kariagepompadour/KariPom/docs/karipom_ear/Karipom Ear Pico2H 書き込み手順（完成版）.docx

2026/07/18

# Karipom Ear Pico2H 書き込み手順（完成版）

対象スケッチ

pico2-pcm1808/karipom_pico2/karipom_pico2.ino（GitHub公開版。旧開発名：Karipom_Ear_Pico_Step2_UART_Echo）

※スケッチ内部のヘッダには開発当時の名称（Step2）が残っていますが、中身は完成版です。

# ① Pico2HをBOOTSELモードにする

1. Pico2Hの BOOTSELボタン を押したまま
2. USBケーブルをMacへ接続
3. BOOTSELボタンを離す

Finderに

RPI-RP2

というドライブが現れればOK。

# ② Arduino IDEを起動

開くスケッチ

pico2-pcm1808/karipom_pico2/karipom_pico2.ino（GitHub公開版。旧開発名：Karipom_Ear_Pico_Step2_UART_Echo）

# ③ ボード設定

ツール → ボード

Raspberry Pi Pico/RP2040

↓

Raspberry Pi Pico 2

# ④ ポート設定

ポートは

UF2 Board

または

RPI-RP2

を選択。

※通常の /dev/cu.usbmodem... はまだ表示されなくて正常。

# ⑤ 書き込み

Arduino IDE の

→（書き込み）

を押す。

数秒で

Done uploading.

になれば成功。

Pico2Hは自動で再起動する。

# ⑥ シリアルモニタ

再起動後、

ツール → ポート

から

/dev/cu.usbmodem******

を選択。

シリアル速度

115200

# ⑦ 動作確認（無音時）

正常なら

ST> rmsDb=-98.0 gate=closed fft/s=25 mi=0 ovf=0 lb=--

TX> FFT:0,0,0,0,0,0,0,0

のような表示が出る。

確認ポイント

- ✅ gate=closed
- ✅ fft/s=25
- ✅ mi=0
- ✅ ovf=0

# ⑧ PCM1808接続後

音楽を流すと

gate=open

となり、

FFT値が変化すれば正常。

# ⑨ CoreS3接続後

CoreS3側で

EAR SPEAK_START

が表示され、

- グライコ
- 口パク

が動けば完成。

## 現在の完成版ファイル

### Pico2H

pico2-pcm1808/karipom_pico2/karipom_pico2.ino（GitHub公開版。旧開発名：Karipom_Ear_Pico_Step2_UART_Echo）

### CoreS3

karipom_20260716_EAR_STEP5_1.ino

💡 メモ

フォルダ名が「Step2」のため紛らわしいですが、Pico2H側はこのStep2が最終完成版です。CoreS3側だけが Step5.1 まで進化しています。
