kariagepompadour/KariPom/sdcard/faces/karipom_default.png

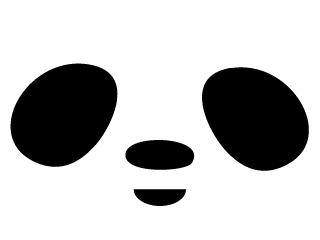
sdcard/faces/karipom_default.png
