kariagepompadour/KariPom/sdcard/faces/kawaii_01.png

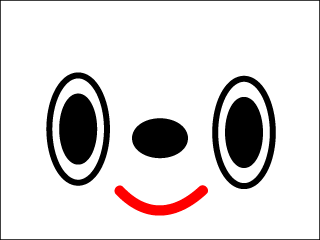
sdcard/faces/kawaii_01.png
