kariagepompadour/KariPom/sdcard/faces/kawaii_02.png

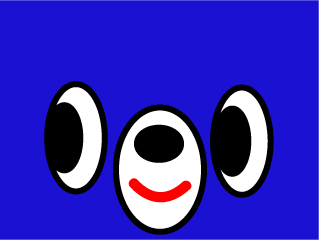
sdcard/faces/kawaii_02.png
