kariagepompadour/KariPom/sdcard/faces/kawaii_03.png

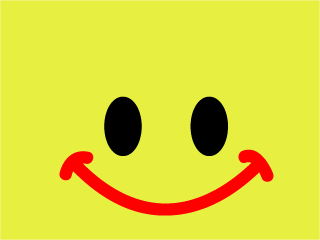
sdcard/faces/kawaii_03.png
