kariagepompadour/KariPom/sdcard/faces/kawaii_04.png

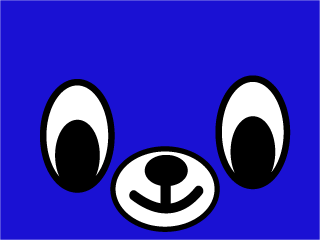
sdcard/faces/kawaii_04.png
