kariagepompadour/KariPom/sdcard/faces/kawaii_05.png

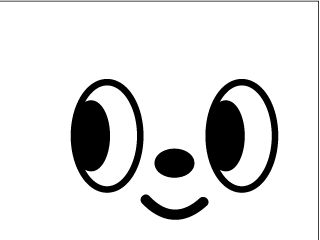
sdcard/faces/kawaii_05.png
