kariagepompadour/KariPom/sdcard/faces/kawaii_06.png

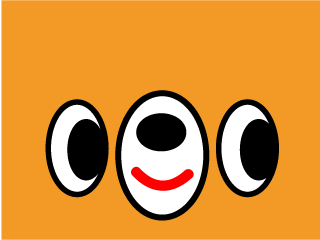
sdcard/faces/kawaii_06.png
