kariagepompadour/KariPom/sdcard/faces/nazousa_pink.png

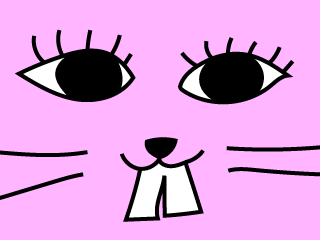
sdcard/faces/nazousa_pink.png
