kariagepompadour/KariPom/sdcard/faces/robo_white.png

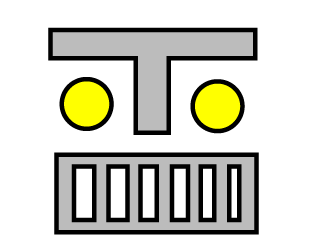
sdcard/faces/robo_white.png
