kariagepompadour/KariPom/sdcard/faces/smile_320x240.png

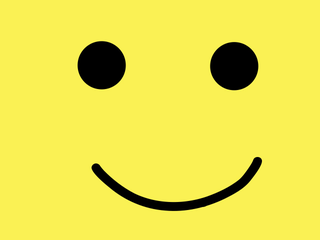
sdcard/faces/smile_320x240.png
