kariagepompadour/KariPom/3d_models/karipom.3mf

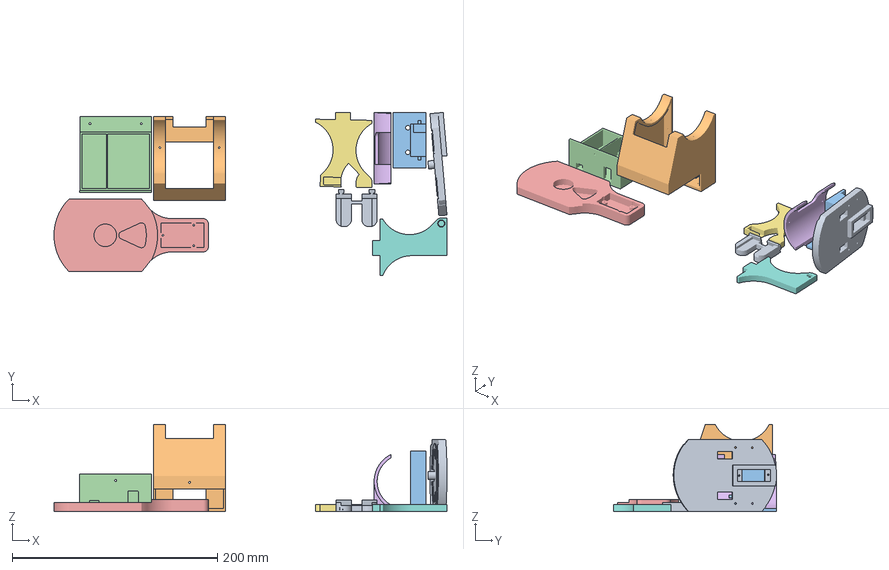
[picture p17: CAD file, 2026-08-01]
3d_models/karipom.3mf
383.1 x 159.1 x 85.2 mm
コンポーネント1.stl
コンポーネント12.stl
ボディ47.stl
ボディ1.stl
ボディ74.stl
コンポーネント9.stl
コンポーネント7.stl
コンポーネント2.stl
ボディ18_fixed.stl
