kariagepompadour/KariPom/3d_models/stl/karipom_hip_lineout.stl

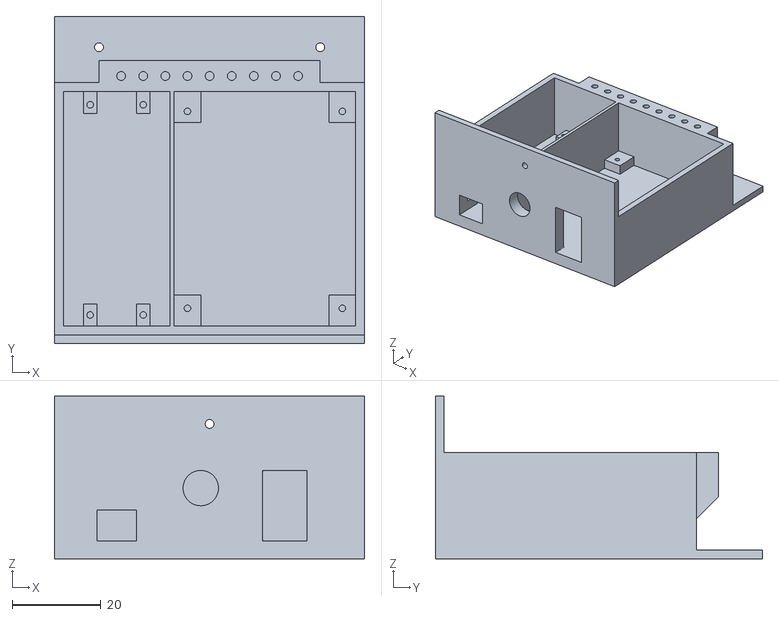
[picture p18: CAD file, 2026-08-05]
3d_models/stl/karipom_hip_lineout.stl
70.1 x 74.0 x 36.8
