kariagepompadour/KariPom/3d_models/stl/karipom_body.stl

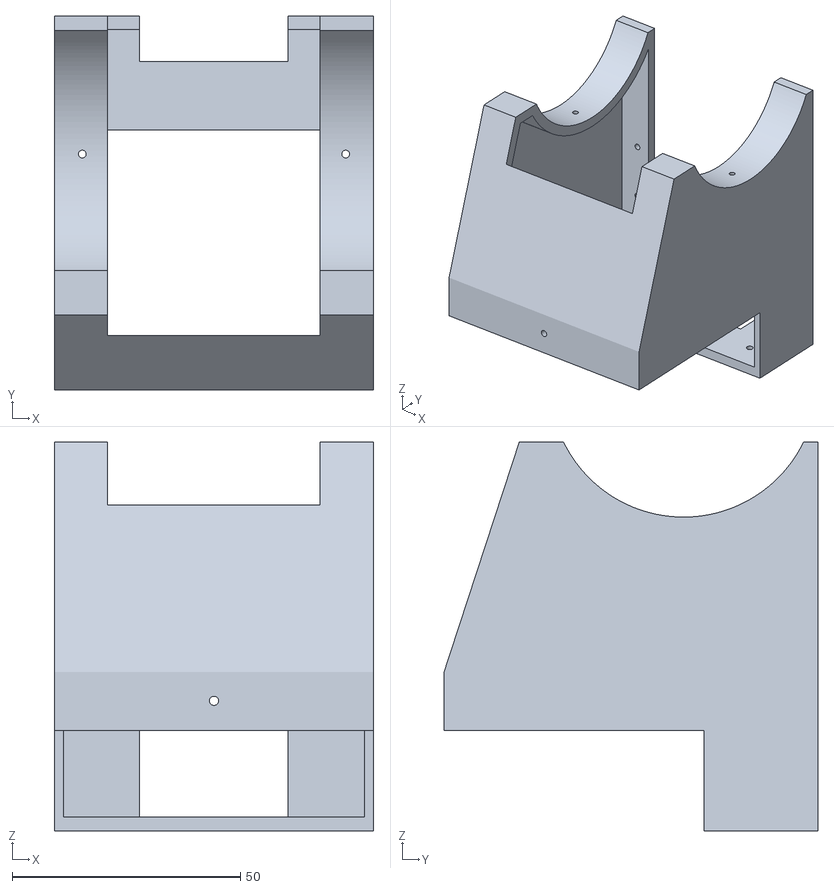
[picture p19: CAD file, 2026-08-01]
3d_models/stl/karipom_body.stl
70.0 x 82.0 x 85.2
