kariagepompadour/KariPom/3d_models/stl/karipom_pelvis.stl

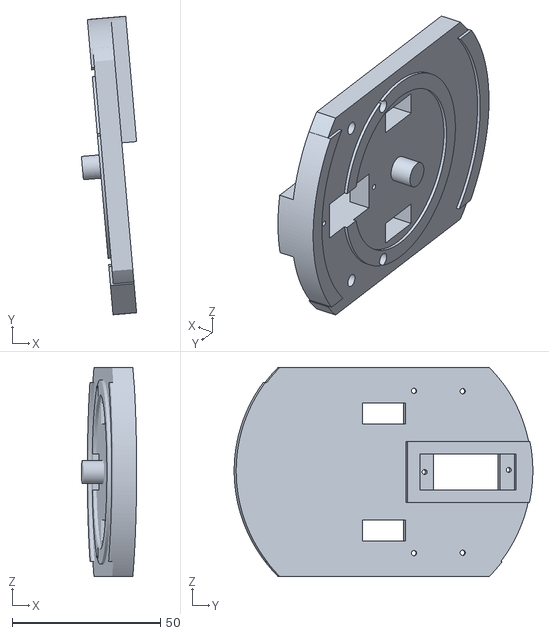
[picture p20: CAD file, 2026-08-01]
3d_models/stl/karipom_pelvis.stl
18.6 x 100.7 x 70.5
