kariagepompadour/KariPom/3d_models/stl/karipom_left_shoulder.stl

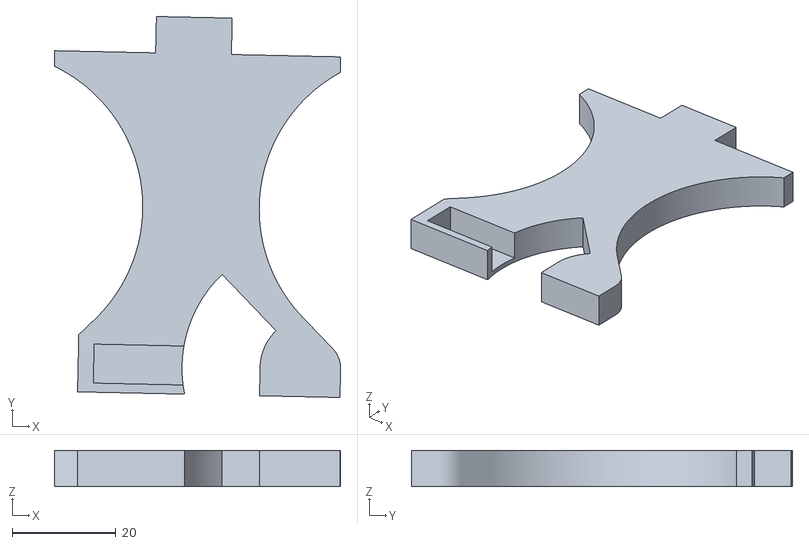
[picture p21: CAD file, 2026-08-01]
3d_models/stl/karipom_left_shoulder.stl
55.1 x 73.3 x 7.00
