kariagepompadour/KariPom/3d_models/stl/karipom_right_shoulder.stl

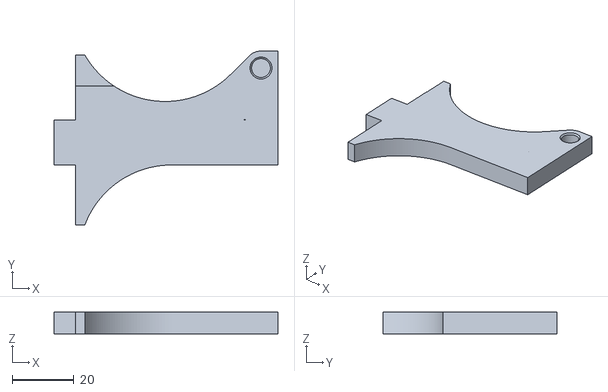
[picture p22: CAD file, 2026-08-01]
3d_models/stl/karipom_right_shoulder.stl
72.5 x 56.3 x 7.00
