kariagepompadour/KariPom/3d_models/stl/karipom_ears.stl

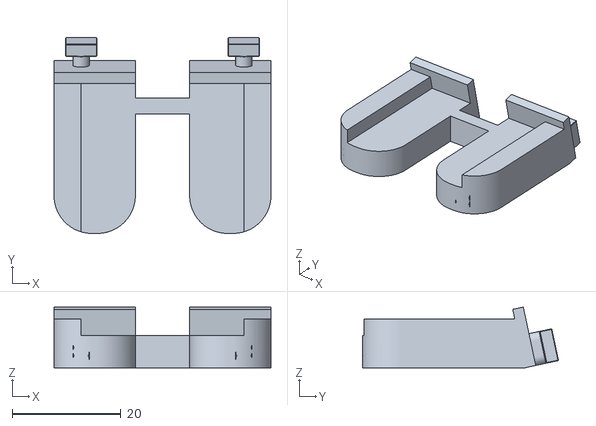
[picture p23: CAD file, 2026-08-01]
3d_models/stl/karipom_ears.stl
40.0 x 36.1 x 11.2
