kariagepompadour/KariPom/3d_models/stl/karipom_feet.stl

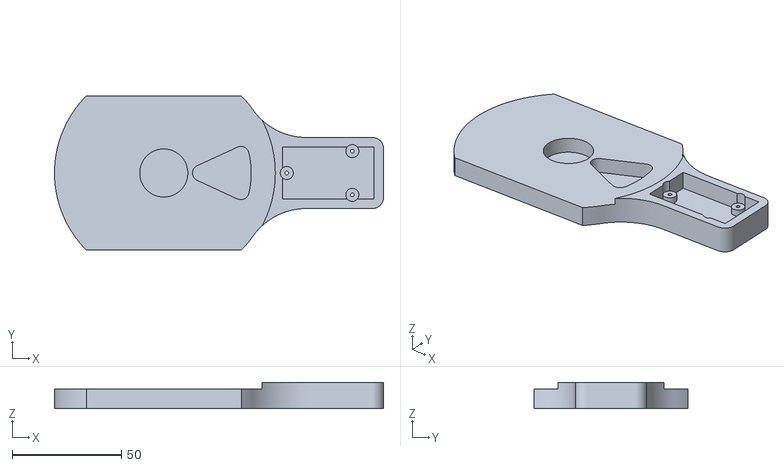
[picture p24: CAD file, 2026-08-01]
3d_models/stl/karipom_feet.stl
150.5 x 70.5 x 12.0
