kariagepompadour/KariPom/3d_models/stl/karipom_spinal_cord.stl

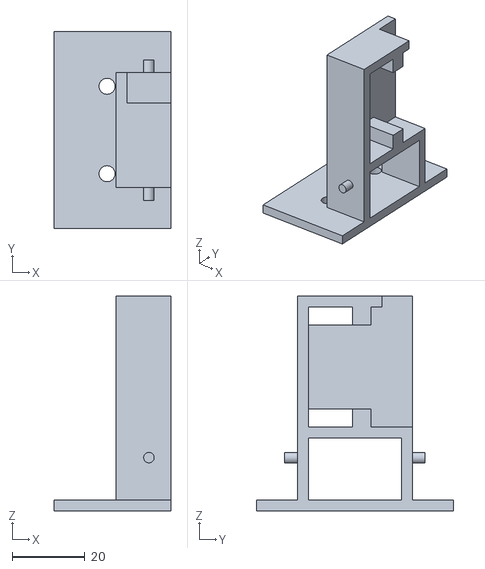
[picture p25: CAD file, 2026-08-01]
3d_models/stl/karipom_spinal_cord.stl
32.0 x 54.0 x 59.0
