kariagepompadour/KariPom/3d_models/stl/karipom_chest.stl

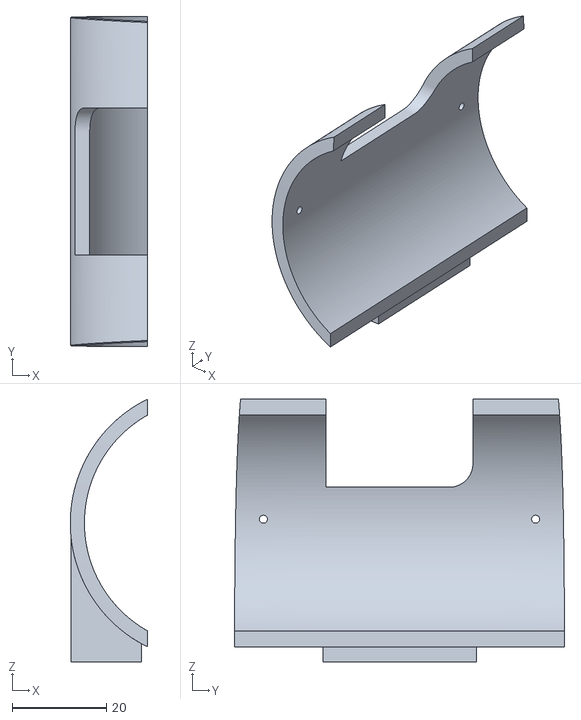
[picture p26: CAD file, 2026-08-01]
3d_models/stl/karipom_chest.stl
16.4 x 70.0 x 55.8
