kariagepompadour/KariPom/3d_models/stl/karipom_hip.stl

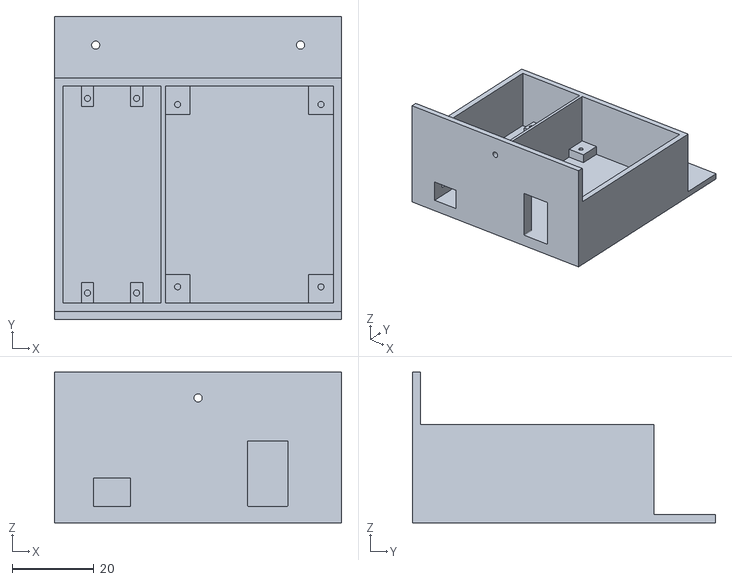
[picture p27: CAD file, 2026-08-01]
3d_models/stl/karipom_hip.stl
70.1 x 74.0 x 36.8
