kariagepompadour/KariPom/(commit log)

2026-07-31 初回コミット: KariPomプロジェクトの整理・構成統一
2026-07-31 Visualizer: Mega Blocks（仮称）を追加
    - 大型落ち物ブロックが顔の周囲を落下・90度回転・左右移動する新Visualizer
    - 8-Lane Rhythmの固定8レーン方式とは別系統（列マッピング不使用、少数ブロックが自由に移動）
    - ブロックサイズはEYE_RADIUS(20)/FACE_MOUTH(90x105)を基準に1セル40pxで設計
    - 既存のenum/テーブル拡張手順（VisualizerMode, VIZ_MODES[], VIZ_RENDER_FN[], VIZ_INTERVAL_MS[]）に
    沿って追加。既存Visualizer/Lighting/顔描画/WebUI/設定保存のコードは無変更（追記のみ）
    - 顔はブロック描画後に最後に描画し、常に手前に表示されるようにした
    - g+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
2026-07-31 Tetromino Dance: 実機確認結果を反映した修正
    1. 背景を黒→白へ変更。他の白背景Visualizerと同じ扱いにし、黒背景専用だった
    顔まわりの白下地処理（fillCircle/fillEllipse/fillRectの3行）を撤去。
    2. 回転を瞬間切り替え→連続アニメーションへ変更。
    - ピースを外接矩形の左上ではなく中心(cx,cy)で管理するよう変更
    - angleがtargetAngle（常に+90度）へBLK_ROT_STEP(約0.26rad/フレーム、
    6フレームで90度)ずつ近づく
    - 各セルの4頂点を回転行列でangle分変換し、fillTriangle×2枚で描画
    - 中心は回転で動かないため、その場でクル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
2026-07-31 requirements.txt: PyQtWebEngineの記載漏れを追加
    venvの依存パッケージ一覧をdist-infoから機械的に拾った際、PyQtWebEngineが
    未インストールだったため漏れていた。Companion GUIのLab（埋め込みブラウザ）
    機能が動くにはPyQt5本体とは別にこのパッケージが必要。PyQt5 5.15.11と
    組み合わせる場合はPyQtWebEngine 5.15.7が対応バージョン。
2026-07-31 マニュアルをVer.2.0に改訂（Visualizer/Lighting章追加、docxのページ区切り・表幅を修正）
2026-07-31 マニュアル: WebUIをブラウザ/KariPom Companionの2通りで説明し、Companionの4タブ（Lab/BBX/Talk/Log）を第15章に詳述
2026-07-31 マニュアル: 9.3章末にKariPom Companionの3タブ（Talk/Log健康診断/BBX）の要約を追記
2026-07-31 マニュアル: 15.1のタブ表（9.3と重複）を削除し共通設定欄の説明のみ残す
2026-07-31 マニュアル: 別冊上級者向け資料への参照を削除し、AIに読み込ませて進める案内に統一
2026-07-31 マニュアルVer.3.0: GitHub公開版として全面アップデート
    - 第2章をプロジェクトの成り立ち（Stack-chan由来→口パク研究→BBX発見→Ear/Visualizer/Lighting→Desktop→Pico2構想）が伝わるストーリー構成に書き換え
    - KariPom Desktop（PC単体版、Win/Mac/Linux対応）の説明を第2章に追加
    - KariPom Companionを『統合管理ツール』として位置付け直し（第9章・第15章）
    - Python環境構築の説明を最小化し、AIに読み込ませて相談する運用に統一
    - 対応OSをWindows・macOS・Linuxに更新、音源表示名を「PC音声（Wi-Fi）」に統一（Mac限定表現を排除）
    - Karipom Earに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
2026-08-01 マニュアルVer.3.0 最終ブラッシュアップ
    - 第2章: 口パク研究中の偶然の発見からBBXへ発展した、というストーリー性を強化
    - BBXを一般的な略称でなく、本プロジェクト独自の呼び方として明記
    - PCM1808+Pico2の効果を『CoreS3単体』ではなく『拡張構成を追加するとPC不要になる』と正確化（第2章・第12章）
    - 巻末フッターのバージョン表記をVer.3.0に修正
2026-08-01 マニュアルVer.3.1: 読みやすさの微調整
    - 第3章の機能一覧を『本体機能／BBX機能／PC連携』の3カテゴリ表に整理
    - 第15章KariPom Companionの冒頭を、日常的に使うPCアプリという印象が伝わる表現に調整
    - 用語集BBXの説明順を、独自呼称であることが先に伝わる形に修正
2026-08-01 マニュアルVer.3.2: 第2章のみ微調整
    - PCM1808+Pico2を『将来構想』ではなく『発展的なオプション構成』として紹介し、設計図・回路図・製作マニュアルのGitHub公開予定に言及（継続改良中である点も明記）
    - 第2章末に『2.5 どこから始める？（3つの構成）』を新設し、Desktop→CoreS3+Companion→CoreS3+PCM1808+Pico2の3段階の始め方を紹介
    - 他の章・ページ構成は変更なし
2026-08-01 PCM1808+Pico2設計マニュアル(GitHub公開用)を新設
    - docs/karipom_ear/配下の5つの内部エンジニアリング文書を統合
    - 13章構成：概要/設計思想/部品表/配線/ジャンパ設定/CoreS3側変更/組み立て手順/
    通信プロトコル/トラブルシューティング/完成チェックリスト/LINE OUT増設(発展オプション)/
    ロードマップ/用語集
    - 実配線図・デバッグフローチャート図を同梱
    - Phase 0はCoreS3実機連携まで達成済みであることを確認して明記
    - ユーザーマニュアルとトーンを統一しつつ、技術的な内容・回路図・注意事項・
    トラブルシュートは省略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
2026-08-01 Karipom Ear設計マニュアルをVer.2.0へ統合改訂
    - LINE OUT増設 作業手順書・MH-M18初回通電/DCオフセット測定マニュアルを
    第11章・第12章として本編へ統合
    - 第11章「LINE OUT増設」：470Ω挿入の設計理由、部品表、11工程の作業手順、
    トラブルシューティングまで完全版として再構成
    - 第12章「Bluetooth入力（MH-M18）」を新設（旧・今後の発展ロードマップ章を置換）
    - Karipom Ear v3開発ログ（M3a入力レベル評価）から設計判断根拠を反映
    （有線LINE IN基準値、Bluetooth入力目標レベル、比率校正方式）
    - MH-M18初回通電・DCオフセッ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
2026-08-01 第11章・第12章に作者注を追加：設計資料と実装状況を明確化
    - 第11章LINE OUT増設：設計・製作手順は完成しているが、Karipom Ear本体への
    増設は未実施（音源機器側のLINE OUT分岐で運用中）である旨を明記
    - 第12章Bluetooth入力（MH-M18）：入力レベル評価・DCオフセット測定の設計・
    評価までは実施済みだが、LINE OUT構成で十分なため当面搭載予定なしである
    旨を明記
    - いずれも「設計資料として掲載しているオプション機能」であることを
    GitHub公開用マニュアルとして明確化し、実装済み/未実装の誤解を防止
2026-08-01 第11・12章の作者注を実際の運用状況に合わせて修正
    - 第12章冒頭：現在の実際の推奨構成は第2〜10章のPCM1808+Pico2基本構成であり、
    LINE OUT増設・Bluetooth入力はいずれも発展的オプションの設計資料である旨へ修正
    - 第12章作者注：LINE OUT・Bluetoothとも実機未搭載である現状を明記
    - 第11章作者注：「Mac／スマホ側」→「音源機器側」に変更し、将来の音源機器の
    変化に依存しない表現へ統一
2026-08-01 かりポムユーザーマニュアルVer.4.0：Karipom Ear設計マニュアルと補完し合う構成へ整理
    - 1.1にGitHub公開5点セット（ユーザーマニュアル／Karipom Ear設計・製作
    マニュアル／Arduinoソース／Pythonソース／3Dデータ）を明記し、電子工作の
    詳細はKaripom Ear設計・製作マニュアルへ委ねる役割分担を明確化
    - AIに読み込ませながら進める読者を想定した一文を追加
    - 2.5にKariPom Desktop／CoreS3+Companion／CoreS3+Karipom Earの
    3構成比較表を追加し、違いが一目でわかるよう整理
    - 2.2の「設計図・回路図・製作マニュアルはGitHubで公開予定」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
2026-08-01 かりポムユーザーマニュアルVer.4.1：GitHub公開前の最終ブラッシュアップ
    - 第2章：KariPom Desktopの位置付けを「体験版」から「BBX機能だけを独立
    させたスタンドアロン版」へ修正（2.3・2.4・2.5）。CompanionのKariPom BBX
    タブとの違いが伝わる表現に統一
    - 第15章：KariPom CompanionとKariPom Desktopの使い分けが一目でわかる
    比較図（CoreS3あり→Companion／CoreS3なし→Desktop）を15.1に追加
    - 第12章：LINE OUT増設・Bluetooth入力（MH-M18）に、作者自身は未実装で
    ある旨と理由を記した作者注を追加（Karipom Ear設計・製作マニュアルの
    作者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
2026-08-01 かりポムユーザーマニュアルVer.4.2：GitHub公開前の最終査読
    - 「開発中」表現を整理：2.4・2.5でPCM1808+Pico2構成を指していた箇所を
    「継続的にアップデート中」へ変更。カメラ機能・自律会話機能など本当に
    未実装のものは「開発中」のまま維持
    - 第2章のBBXの説明を補強：口パクだけでなく、首振り・Karipom Ear・
    Visualizer・Lightingを組み合わせた世界観全体であることを一段落で明記
    - 第2章・第15章のCompanion/Desktop説明の重複を整理（2.3の重複説明を
    15.1への参照に統一）
    - 【自主修正】BBXの定義強化に伴い、Desktopの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
2026-08-01 かりポムユーザーマニュアルVer.4.3：文章のみの最終ブラッシュアップ
    - 用語集・第2章のBBXの説明を「Beat Boxから着想を得て、独自に名付けた」
    という表現へ調整し、独自呼称であることがより自然に伝わるよう修正
    - 2.5のKariPom Desktopの説明を「PCだけでBBXを楽しめるスタンドアロン版」
    へ簡潔化（詳しい説明は2.3にそのまま維持し、重複感を軽減）
    - 第12章LINE OUT増設の作者注に「CDプレーヤーやBluetoothレシーバーなど」
    という具体例を追記し、初心者にも分かりやすく補足
    - FAQ「Desktopだけでも遊べますか？」の回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
2026-08-01 Karipom Ear設計マニュアル: GitHub公開に向け作者固有環境を一般仕様から分離
    - 第11章 LINE OUT: 配線色（青/赤/黒）による指示をTip/Ring/Sleeve基準に統一。
    色は「作者の製作例」として注記に分離
    - 第11章: ジャック配線の入手・自作方法のガイダンスを追加（テスターでの端子確認を明記）
    - 第11章: 未定義だった内部工程参照「M2」を削除し、自己完結した説明に書き換え
    - 第1章/第11章: Mac限定の比較・手順表現をPC/音源機器全般に一般化（BlackHoleは注記化）
    - 第2章: システム図の音源例をMac→PCに一般化
    - 第4章: Port Cの「青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
2026-08-01 Karipom Ear設計マニュアル: 第9章Grove配線色・第11章抵抗カラーコードの一般化
    - 第9章 9.2: 「黄と白の配線を入れ替えて再確認」という色依存の対処を、
    Port CのG17/G18とPico 2のTX/RXという端子名・信号名基準の再確認に変更。
    第4章のGrove線色注記（ロットにより異なる）と方針を統一。
    作者の製作例（黄=G17、白=G18）は注記として残す
    - 第11章 11.2: 470Ωのカラーコードを「黄・紫・茶・金」と断定する書き方から、
    帯の本数・配色は抵抗の種類・精度により異なる旨を明記し、
    カラーコードを確認方法の一つ（4本帯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
2026-08-01 かりポムユーザーマニュアル: GitHub公開前監査に基づく筐体色・第5章・FAQ・参照先の修正
    - 第2章2.1: 「ピンクとティファニーブルーの2色の筐体がある」という正式仕様的な
    表現を、筐体は3Dプリントで色は自由に選べる旨に修正。ピンク/ブルーは
    作者の製作例として位置付け直す
    - 第5章: 「パッケージを受け取る」前提の説明（内容物確認・同梱物・製作者へ連絡）を、
    GitHub公開の3Dプリントデータ等から自作する前提の説明に変更。
    部品項目自体は追加・削除せず、本体色の項目のみ「3Dプリント筐体×1（色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
2026-08-01 3d_models: GitHub公開用3Dプリントデータを新設・整理
    - 3d_models/karipom.3mf: 完成セット（全パーツ統合・推奨データ）
    - 3d_models/stl/: 個別パーツ用の汎用STLデータ9点
    karipom_body / karipom_chest / karipom_hip / karipom_pelvis /
    karipom_spinal_cord / karipom_left_shoulder / karipom_right_shoulder /
    karipom_ears / karipom_feet
    既存コード・マニュアル・その他ファイルは変更なし
    [karipom.3mf, karipom_body.stl, karipom_chest.stl, karipom_ears.stl, karipom_feet.stl, karipom_hip.stl, karipom_left_shoulder.stl, karipom_pelvis.stl]
2026-08-01 ユーザーマニュアルVer.4.4: 第5章「用意するもの」を全面改訂
    基本のかりポムを第三者が自作するために必要な部品・工具を、確定
    済み仕様のみで整理し直した。
    - 5.1 基本のかりポムに必要なもの: M5Stack CoreS3（DIN Base付属、
    分離購入ではないことを明記）、SG90サーボ×2、Groveジョイス
    ティック（Seeed Studio）、MF63ZZベアリング×2、608ベアリング
    ×1、さらタッピングビス（2×8mm・2×10mm、数量は要確認）、
    microSDカード（Wi-Fi設定保存のため必須）などを一覧化
    - 5.2 工具・製作用設備: Arduino IDE用PC、USBケーブル、3Dプ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
2026-08-01 ユーザーマニュアルVer.4.5: 表紙を実機写真化・第5章写真埋込み修正・SD/NVS記述統一
    ■ 表紙
    表紙の説明文プレースホルダーを、作者製作機（ピンクとティファニー
    ブルーのかりポム2台、背景にKariPom Lab画面）の実機写真へ差し替え。
    写真自体は無加工・無トリミングで使用し、2台とも欠けることなく
    表示される。既存のタイトル・サブタイトル・日付表記は維持し、
    画像は独立したブロックとして配置したため文字との重なりはない。
    ■ 第5章の実機写真
    Ver.4.4で追加した4枚の写真参照（{width=60%}等のパーセント指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
2026-08-01 GitHub公開直前の最終整理: README/LICENSE新設・表紙公開版差替・Desktop URL確定・作者IP除去
    ■ README.md新設
    個人製作作品の記録・共有というリポジトリの目的、基礎知識が必要である
    こと、個別サポートを行わないことを明記。主要フォルダ案内、2冊のマニュ
    アルへの導線、3Dモデル案内、姉妹プロジェクトKariPom Desktopへのリンク、
    ライセンス概要表を掲載。
    ■ LICENSE.md新設
    ソースコードには独自の非商用ライセンス（個人製作・改変・非商用共有は
    許可、販売・商用組込は禁止）、3Dモデル・文書・画像にはCC BY-NC 4.0を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
2026-08-01 著作権者表記をKariage POMPADOUR Entertainment Corporationへ統一
    KariPom Desktopリポジトリとの権利者名統一のため、著作権者表記を
    「Copyright (c) 2026 Kariage POMPADOUR Entertainment Corporation」
    に変更した。
    - LICENSE.md: コードライセンスのCopyright行、およびCC BY-NC 4.0の
    クレジット表示先を更新
    - README.md: フッターの©表記を更新
    - ユーザーマニュアル(Ver.4.6) md/docx: 末尾の©表記を更新
    - Karipom Ear設計・製作マニュアル(Ver.2.1) md/docx: 末尾の©表記を更新
    ライセンスの内容（許可・禁止事項）、版数、技術内容は一切変更なし。
    両docxはmdから再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
2026-08-05 Update docs: LINE OUT built, Sleep Carousel, macOS/standalone notes
    実機実装に合わせたドキュメント更新（karipom_cores3.inoの未コミット変更は含まない）。
    - Karipom Ear設計・製作マニュアル: 第11章LINE OUTを実機製作・動作確認済みへ改訂、写真4枚追加、入力注意コラム追加。第12章冒頭の矛盾を修正。Ver.2.2
    - ユーザーマニュアル: 10.3 睡眠モード(Sleep Lighting Carousel)を新設。macOS複数出力装置の注意を追加。5.1にサーボ/ジョイスティック/Karipom Ear未接続時の動作継続を追記。AIダブルクリック起動ランチャーの運用を追記。Ver.4.7
    - README.md: LIN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
2026-08-05 Update Sleep Dream Time and Lighting face rendering
    実機コンパイル・実機確認をしながら調整してきたSleep Lighting Carousel（Dream Time）と、通常Lighting表示中の顔パーツ白縁取りをcommit。
    - Sleep: 入眠直後3分間は従来どおり閉じ目＋Zzz。その後Dream Time（Sleep Lighting Carousel）へ移行し、Face Galleryと『目×Lighting』（時計／閉じ目／Eye Slotの目をランダム選択、Eye Slotは背景Lighting候補から除外）を3分周期で切り替え。Dream Time中はZzz非表示。
    - 通常Lighting: 目・鼻・鼻口の縦線・口の白縁取りを、白backingを全パーツ先に描いてから黒/赤本体を描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
2026-08-05 Add LINE OUT option case STL, update Ear manual and README
    既存の標準筐体 karipom_hip.stl（PCM1808＋Pico2収納）に、3.5mm LINE OUTジャック用の開口を追加したオプション版 karipom_hip_lineout.stl を追加。
    - 3d_models/stl/karipom_hip_lineout.stl: 新規追加。karipom_hip.stlの派生モデル（バウンディングボックス一致を確認済み）。LINE OUT増設時のみ使用するオプション版で、標準構成では従来どおりkaripom_hip.stlを使用する。
    - Karipom Ear設計・製作マニュアル: 11.3・11.6に、標準／LINE OUTオプションの関係を明記。Ver.2.2→2.3。既存のLINE OUT回路・写真・注意事項等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
    [karipom_hip_lineout.stl]
2026-08-07 Fix Eye Slot being covered by full-screen Visualizer draws
    Lighting上でEye Slot（お目々スロット）を選択している状態でKaleidoscope/
    Analogue VU等の全画面描画Visualizerを選ぶと、統合描画パイプライン
    （Lighting背景→Visualizer→顔）でVisualizerの全画面描画がEye Slotの
    リールを上書きし、目が見えなくなる不具合を修正した。
    - sceneComposeAndPush()にLayer3.5として「Visualizer描画直後・顔レイヤーの
    直前」にEye Slotのリールだけを最前面へ再描画する処理を追加。
    gEyeSlotActive && vizOnのみで判定するため、Visualizerの種類ごとの
    個別処理は一切追加し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
2026-08-09 Add Aquarium and Flying Pompadour lighting modes; add colorful starfield to space lightings; fix Lighting top-panel white flash
    - Add Aquarium: large tropical-fish aquarium background Lighting (few
    large fish with distinct body shapes/fins/patterns, bubbles, weeds,
    rocks, sand; realistic small black fish eyes, no white sclera)
    - Add Flying Pompadour: winged CoreS3-styled KariPom flying diagonally
    from upper-right to lower-left across the screen, an original homage
    to classic screensaver aesthetics (not a reproduction of any specific
    work). CoreS3-shaped body with white display showing KariPom's face,
    bird-like wings, rabbit ears mounted on the rear-top of the body,
    near/mid/far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
2026-08-09 docs: Lighting一覧にAquarium/Flying Pompadourを追加し、モード数を16→18に更新
    - README.md: Lighting（16種）→（18種）
    - docs/manual/karipom_manual.md: 14.4のLighting一覧表にAquarium・Flying Pompadourを追加。
    各所のモード数表記（機能一覧表、設定リファレンス、用語集）を16種類→18種類に更新。
    - docs/manual/karipom_manual.docx: 上記.mdと同内容をdocx側にも反映（見出し・一覧表・モード数表記）。
    コード側の機能追加（Aquarium/Flying Pompadour Lighting、Asteroid Field/Tempest Tunnel/
    Missile Defenseへのカラフルな星空背景追加、Lighting表示中の上部ステータス領域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
2026-08-10 Add Visualizer preview switching to KariPom Companion
2026-08-11 Add Flower Clock Lighting
    Adds a new Lighting mode "Flower Clock": a 320x192 radial 12-color
    clock face with a rounded-rectangle white dial, 12/3/6/9 numerals,
    and pink/purple hands drawn in front of the face layer.
    - Registers LIGHT_FLOWERCLOCK in the enum/LIGHT_MODES/LIGHT_LAYER/
    LIGHT_HEADER/LIGHT_RENDER_FN tables (existing 4-step convention).
    - 12 colors radiate from the central white rounded rect (180x108,
    center 160,144) to the screen edges, with a 15-degree shift so
    each clock-hour direction sits at the center of its color wedge.
    - Hands (long=pink, short=purple, no second hand, no center hub)
    are drawn via a dedicated foreground overlay
    (fcDrawHandsForeground) called from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
2026-08-12 Add PINBALL Arcade Lighting mode
    Adds a 22nd Lighting mode (LIGHT_PINBALL): a fully-automatic pinball
    screensaver that reuses KariPom's actual default face (eyes/nose/
    mouth) as the pinball table's obstacles. Registered via the standard
    4-step Lighting convention (enum / LIGHT_MODES / LIGHT_LAYER+HEADER /
    LIGHT_RENDER_FN) so it's automatically included in Lighting Random
    selection and the Sleep Lighting Carousel.
    Key implementation points, refined over many rounds of on-device
    testing:
    - Playfield boundary defined as a single closed hexagon vertex array
    (PIN_BOUND_X/Y), with fill / outline / collision all generated from
    that one shared definition (no duplicated coordinates).
    - Physics u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
2026-08-12 PINBALL Arcade: remove score display, change nose idle color to orange
    1. lightRenderPinball()内の左上スコア表示（SCORE xxx文字描画）を削除。pinScoreの計算・加算処理（PIN_EYE_SCORE/PIN_NOSE_SCORE）は変更なし。
    2. 鼻の通常時の色を黒からオレンジ(PIN_NOSE_COL)に変更。共通のdrawVisualizerFaceParts()は変更せず、PINBALL専用の最前面フック(4.6)から新設のpinDrawNoseIdle()で上書き描画。形状・大きさ・位置・当たり判定・反射挙動・ヒット時フラッシュは変更なし。
    BASEBALL Arcadeおよび他のLightingモードへの変更なし。
2026-08-12 Fix Sleep Flower Clock hands/bg reset, note text, millis() rollover
    - sleepComposeEyeLightFrame(): reset gLightBgFilled at Layer0 so Laser
    can still draw its own dark background when selected, and draw
    Flower Clock's foreground hands (same technique as the 4.5 hook in
    sceneComposeAndPush()) since Sleep mode never passes through that hook
    - LIGHT_MODES[] note text: sync pinball/aquarium/flowerclock descriptions
    with current rendering (no display score, 2-3 fish, rounded dial with
    4 numerals + 2 hands, no center hub)
    - handleJoystick()/updateMicInput(): replace direct millis() comparisons
    with rollover-safe (long)(millis() - target) < 0 checks
2026-08-12 PINBALL Arcade: fix permanent bounce (limit cycle) above nose
    Root cause: pinCollideNose() enforces PIN_NOSE_KICK=170px/s minimum speed, acting as an energy source. A ball above the nose enters a perfect limit cycle (rise ~55.6px, fall, repeat) with no wall contact and no PIN_REST damping. The existing speed-based stuck check always sees speed>=170px/s and never triggers.
    Fix: add position-based stuck detection. Track a reference position (pinStuckRefX/Y/Ms). If the ball stays within PIN_STUCK_POS_R=62px (> nose bounce amplitude 55.6px) for PIN_STUCK_POS_MS=4000ms, add a lateral nudge of PIN_STUCK_NUDGE_VX=38px/s. Escape is a nudge, not a forced relaunch, so play continues naturally. In nor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
2026-08-12 Web Cockpit: collapse Lighting/Visualizer per-mode descriptions
    - Wrap the per-mode note table (LIGHT_MODES[]/VIZ_MODES[].note) below
    the Lighting and Visualizer mode buttons in a collapsible
    <details class='desc-toggle'> block, closed by default, toggled via
    a text-only summary ("▶ 説明を見る" / "▼ 説明を閉じる", CSS-only,
    no JS). Existing note content is unchanged.
    - Reorder each section so operation UI (mode buttons, Random,
    Lighting Brightness) stays fully visible above a reused <hr>
    divider, with the collapsible per-mode description area placed
    last.
    - Move the Audio Visualizer section's overall summary note (common
    to all modes, not mode-specific) to sit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
2026-08-13 8-Bit Runner: redraw runner as right-facing side view
    Rework marDrawPlayer() only. Same palette (red / blue overalls /
    skin / dark brown / black), same block granularity, no growth in
    sprite size (x: px-11..px+12, y: py-46..py).
    - Head: right profile - hair block at the back, single eye, nose
    protruding right, mustache running back from under the nose,
    cap crown plus a brim extending right.
    - Torso: side silhouette, 14px deep. Shirt top row trimmed to
    px+3 so no red shoulder corner sticks out toward the front.
    Bib and one shoulder strap on the front side only.
    - Legs: thigh 6px + shin 4px + shoe 4px, bending at the knee.
    Two-frame run driven by the sign of legPhase (generation sid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
2026-08-14 feat: organize face display into three Face Modes with Face Gallery None
    Reorganize the face display into three user-facing Face Modes:
    KariPom, Miss KariPom, and Face Gallery.
    - Add a Face Gallery "None" option that hides the face layer entirely
    while Lighting and Visualizer keep running full screen.
    - Gate every face-drawing path through a single faceDrawingEnabled()
    check (normal screen, all Lighting modes, all Visualizer modes,
    Sleep Carousel, mutter and the direct-to-LCD fallbacks), so no
    per-mode branching is needed. Lighting-owned effects such as Eye
    Slot reels, Flower Clock hands and PINBALL bumpers are kept, since
    they are game objects rather than the face layer.
    - Skip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
2026-08-15 docs: regenerate manual DOCX from Ver. 4.13 Markdown
    Rebuild docs/manual/karipom_manual.docx from the current Markdown so
    the distributed Word version matches Ver. 4.13 (Face Mode, Visualizer
    count wording and the setup option 3 rename).
    Claude-Session: https://claude.ai/code/session_01QvNmcKa7F5gf4ync2cXwL3
2026-08-16 Refine Flying Pompadour wings on CoreS3, add manual changelog entry
    - lightRenderFlyingPompadour(): unify the rear wing to one light-gray tone and
    the front wing to one off-white tone (was alternating two shades per wing),
    shrink the root/mid ellipse sizes slightly while keeping the tip size, and
    draw the front wing after the body panel so it renders in front of the case
    instead of behind it. Drop the unused green accent rectangle under the
    display. Flight logic, ears, body, and all other Lighting modes are
    unchanged. Matches the same adjustment ported to KariPom Desktop this
    session.
    - docs/manual: add a Ver. 4.14 changelog entry documenting the above, and fix
    the cover/foot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
2026-08-17 Add Visualizer usage guard on CoreS3, port BBX GUI (Character/Visualizer/Lighting) to Companion
    CoreS3:
    - Block Audio Visualizer start while on internal mic or with audio
    source OFF; block PC-audio (UDP) start until Companion's FFT feed
    is confirmed live. Selection is reset to OFF and a single dialog
    is shown: "内蔵マイクモードではAudio Visualizerは使用できません。"
    - Fix a brief white-flash on the warning by returning to KariPom Lab
    via redirect and showing the alert after page load, instead of a
    dedicated white intermediate page.
    KariPom Companion (mac-companion/karipom_companion.py):
    - Port the KariPom Desktop v0.4+ Character/Visualizer/Lighting canvas
    and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
2026-08-17 Sync manual DOCX/PDF to Ver. 4.15
    Bring docs/manual/karipom_manual.docx and the newly added
    karipom_manual.pdf in line with the already-committed Ver. 4.15
    Markdown source (karipom_manual.md), via targeted XML edits to the
    existing DOCX (unzip -> replace text in word/document.xml and
    word/footer1.xml -> rezip) rather than a full Markdown->DOCX
    regeneration, to preserve existing images, tables, and layout:
    - Cover subtitle, running footer, and colophon line bumped to
    Ver. 4.15.
    - 15.3 KariPom BBX tab paragraph updated to describe the
    Character/Visualizer/Lighting 3-button operation.
    - 20.7 FAQ: reworded the internal-mic bullet and added a new bullet
    about the PC-audio/Companion FFT rea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
2026-08-17 Replace BlackHole with ScreenCaptureKit on macOS, add BBX nav chevrons
    Migrate macOS PC-audio capture (CoreS3 Web UI copy, Companion Talk/BBX
    engine) from BlackHole 2ch + Multi-Output Device to Apple ScreenCaptureKit
    (macOS 13 Ventura+, no extra driver, one-time recording permission).
    Verified on real hardware. Sync all user docs (manual md/docx/pdf,
    architecture notes) to the new setup and drop stale BlackHole-required
    wording. Also add a drawn-only chevron hint to the Character/Visualizer/
    Lighting 3-button row (click zones and labels unchanged).
2026-08-17 Remove BlackHole dependency from run_talk_mode(); ship prebuilt ScreenCaptureKit helper
    - run_talk_mode()'s macOS path no longer uses find_blackhole_device()/sounddevice.
    It now runs the same ScreenCaptureKit helper subprocess as the GUI path, via a
    new _run_mac_sck_capture()/_run_stream_sck() pair mirroring the existing
    Windows/Linux capture-thread + watchdog structure. Permission denial stops
    the CLI instead of retrying forever.
    - Replaced the runtime swiftc-compile-on-first-run helper build with
    locate_mac_sck_helper(), which simply locates a prebuilt binary bundled in
    mac-companion/resources/. End users no longer need Xcode/Command Line
    Tools/swiftc to run KariPom Companion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
2026-11-06 配線図に保護抵抗がないことを資料に明記
    実配線図には保護抵抗を描いておらず、作者は図のとおり抵抗なしで組み立てて
    問題なく動作した。設計マニュアル、Step1確認手順書、Phase0実装仕様書の
    md と Word 版に、この事実を書き足し、220Ωは誤配線に備えた推奨とした。
